idoria75/4Legged_SpiderBot/docs/nodemcu_32_pins.png

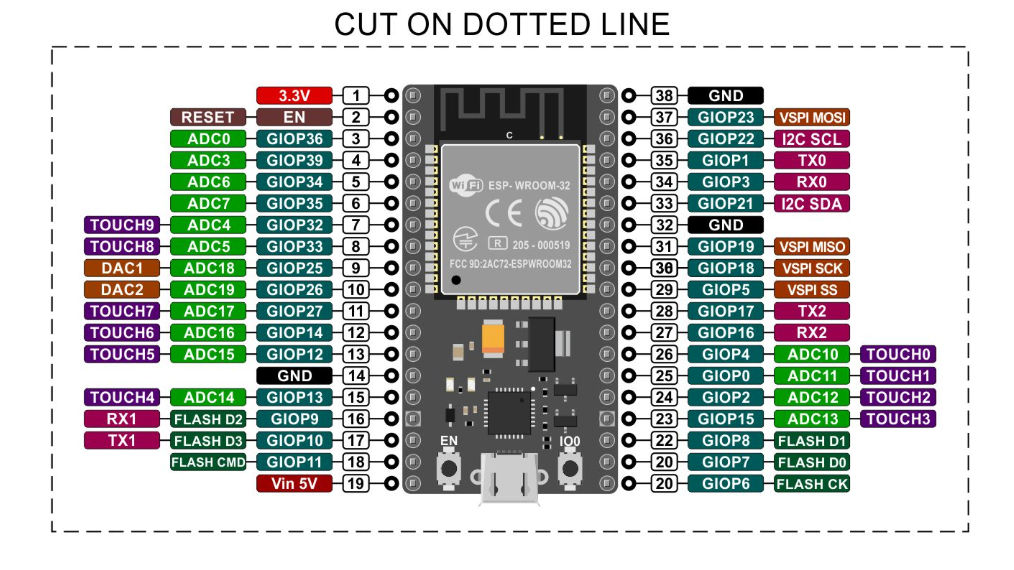
docs/nodemcu_32_pins.png
