idoria75/4Legged_SpiderBot/README.md

# 4Legged_SpiderBot
Version control of a quadruped robot utilizing Inverse Kinematics.
More info can be found on the docs folder.

*Please consider the circuits included in the docs folder instead of the ones found in the reports*

Current development on branch: hotfix.
