idoria75/4Legged_SpiderBot/docs/eagle_brb.png

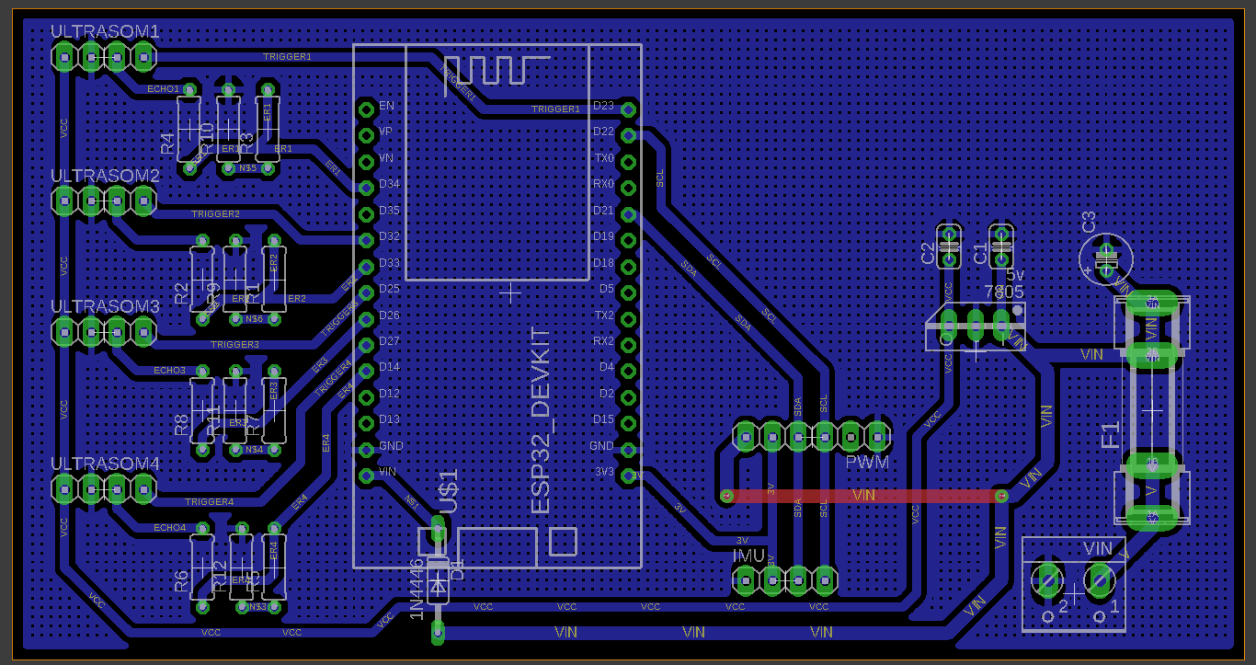
docs/eagle_brb.png
