idoria75/4Legged_SpiderBot/docs/esp32_bootload_programming_connections.jpeg

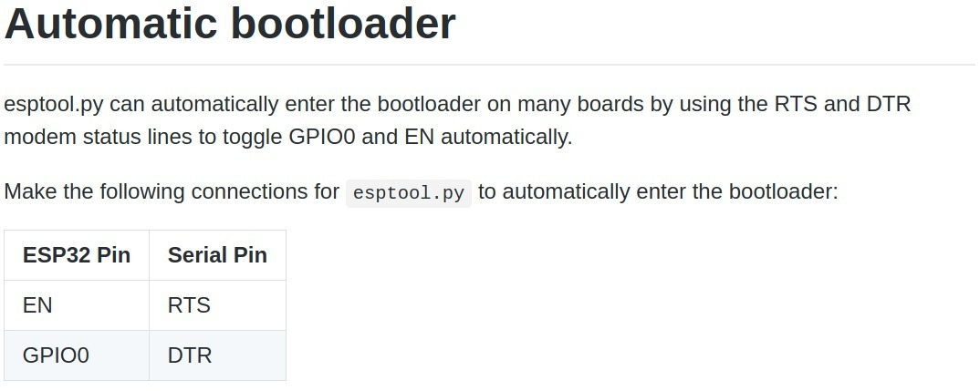
docs/esp32_bootload_programming_connections.jpeg
