idoria75/4Legged_SpiderBot/docs/PCB.brd

## EAGLE design docs/PCB.brd (2019-03-21)

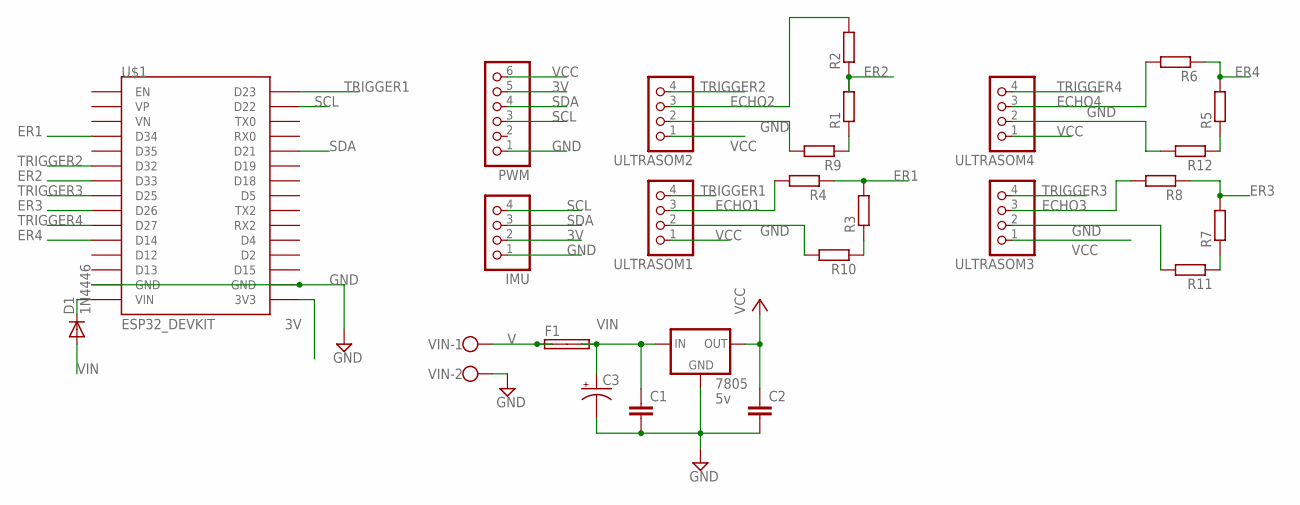
[picture p26: schematic PCB.sch]

Parts:
7805: 5v; 78MXXS
C1, C2: C-EU025-024X044; C025-024X044
C3: CPOL-USE2-5; E2-5
D1: 1N4446; DO35-10
F1: SHK20L
IMU: PINHD-1X4; 1X04
PWM: PINHD-1X6; 1X06
R1, R2, R3, R4, R5, R6, R7, R8, R9, R10, R11, R12: R-EU_0207/7; 0207/7
U$1: ESP32_DEVKIT
ULTRASOM1, ULTRASOM2, ULTRASOM3, ULTRASOM4: PINHD-1X4; 1X04
VIN: W237-102

Connections:
3V: IMU.2, PWM.5, U$1.3V3
ECHO1: R4.2, ULTRASOM1.3
ECHO2: R2.2, ULTRASOM2.3
ECHO3: R8.2, ULTRASOM3.3
ECHO4: R6.2, ULTRASOM4.3
ER1: R3.2, R4.1, U$1.D34
ER2: R1.2, R2.1, U$1.D33
ER3: R7.2, R8.1, U$1.D26
ER4: R5.2, R6.1, U$1.D14
GND: 7805.GND, C1.2, C2.2, C3.-, IMU.1, PWM.1, R9.2, R10.2, R11.2, R12.2, U$1.GND@1 (GND), U$1.GND@2 (GND), ULTRASOM1.2, ULTRASOM2.2, ULTRASOM3.2, ULTRASOM4.2, VIN.2
unnamed: D1.C, U$1.VIN
unnamed: R5.1, R12.1
unnamed: R7.1, R11.1
unnamed: R3.1, R10.1
unnamed: R1.1, R9.1
SCL: IMU.4, PWM.3, U$1.D22
SDA: IMU.3, PWM.4, U$1.D21
TRIGGER1: U$1.D23, ULTRASOM1.4
TRIGGER2: U$1.D32, ULTRASOM2.4
TRIGGER3: U$1.D25, ULTRASOM3.4
TRIGGER4: U$1.D27, ULTRASOM4.4
V: F1.1A, F1.1B, VIN.1
VCC: 7805.OUT, C2.1, PWM.6, ULTRASOM1.1, ULTRASOM2.1, ULTRASOM3.1, ULTRASOM4.1
VIN: 7805.IN, C1.1, C3.+, D1.A, F1.2A, F1.2B

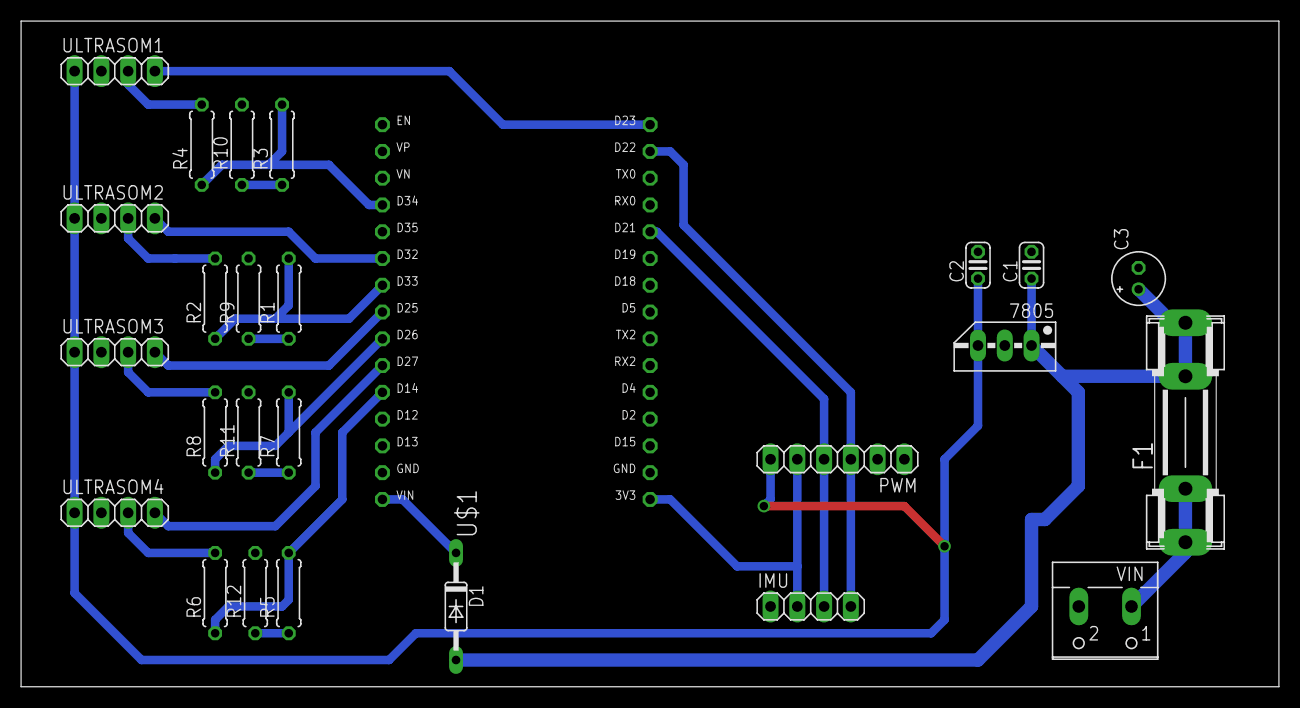
[picture p27: board PCB.brd from above]

Board: 2 copper layers, 119.4 x 63.2 mm, 26 parts (0 on the bottom side), 24 nets.
