idoria75/4Legged_SpiderBot/(commit log)

2018-09-27 Local socket via TCP
2018-10-02 Implement UDP Socket in Python
2018-10-08 Set ESP32 as AP (Router)
2018-10-08 Example with Threads.h
2018-10-08 Add 2nd thread to blink LED
2018-10-09 Add Thread file
2018-10-09 Switch to WebSocket branch with Thread
2018-10-09 Base code with AP and Blink Thread
2018-10-09 First working version os WebSocket Thread, needs more testing.
2018-10-15 Base structure of Switch Case for FSM
2018-10-15 Movimentation FSM with LEDs
2018-10-16 Class Leg working
2018-10-27 Finished moving code to header files, fix websockets code to keep track of number of messages received
    [Definitions.cpp, Definitions.h, Threads.ino, websocket_to_esp32.py]
2018-10-27 Add servotest code
2018-11-01 Finish reading sensor, update JSON based on distance w/o MUTEX
2018-11-05 Fix constructors, update methods
    [Leg.cpp, Leg.h, Robot.cpp, Robot.h, Threads.ino]
2018-11-05 New method to write to servos
2018-11-07 Leg constructors without initial angle definition
2018-11-12 Fix Constructor for Robot
    [Leg.cpp, Leg.h, Robot.cpp, Robot.h, Threads.ino]
2018-11-12 Add Sensor files and update sensor pins
2018-11-13 Move sensors to Robot
2018-11-13 Finish sensor implementation
2018-11-15 Move servo code to leg and make servoDriver static and part of the Leg
2018-11-16 Remove message that caused errors
    [websocket_to_esp32.py]
2018-11-16 Add function to change stance and fix communication problems
    [Definitions.cpp, Leg.cpp, Leg.h, Robot.cpp, Robot.h, main.ino]
2018-11-17 Add makefile, fix OTA IP
    [main.ino]
2018-11-17 Fix espota.py based on latest version
    [main.ino]
2018-11-17 Small fixes to data types
    [Leg.cpp, Leg.h]
2018-11-20 Implement basic movements on servos
2018-11-24 Check working sensors
2018-11-24 Fix sensorData write do json
    [Definitions.cpp]
2018-12-06 try to fix problems with WS and I2C
    [Definitions.cpp, Robot.cpp, Robot.h, USensor.cpp, USensor.h, main.ino, websocket_to_esp32.py]
2019-02-08 remove some prints
2019-03-15 Fix pin assignment
2019-03-21 Add PCB files
    [PCB.brd, PCB.sch]
